Alchemy-Escape-Rooms-Inc/CoveDoor/3DFiles/3MF/LSM_Main_Mount.3mf

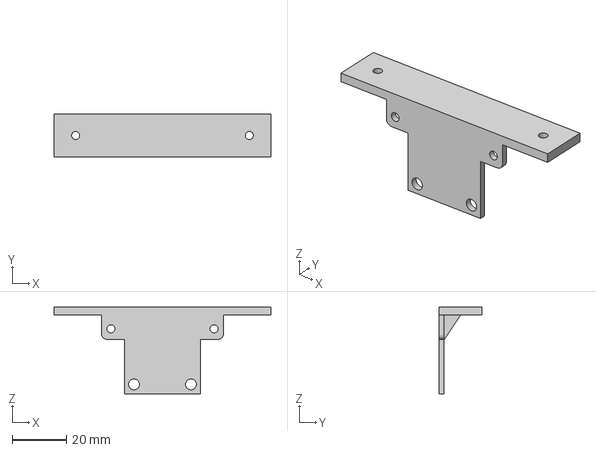
[picture p1: CAD file, 2026-04-08]
3DFiles/3MF/LSM_Main_Mount.3mf
80.0 x 16.0 x 32.0 mm
