Alchemy-Escape-Rooms-Inc/CoveDoor/3DFiles/3MF/Pinion Gear V1 (1).3mf

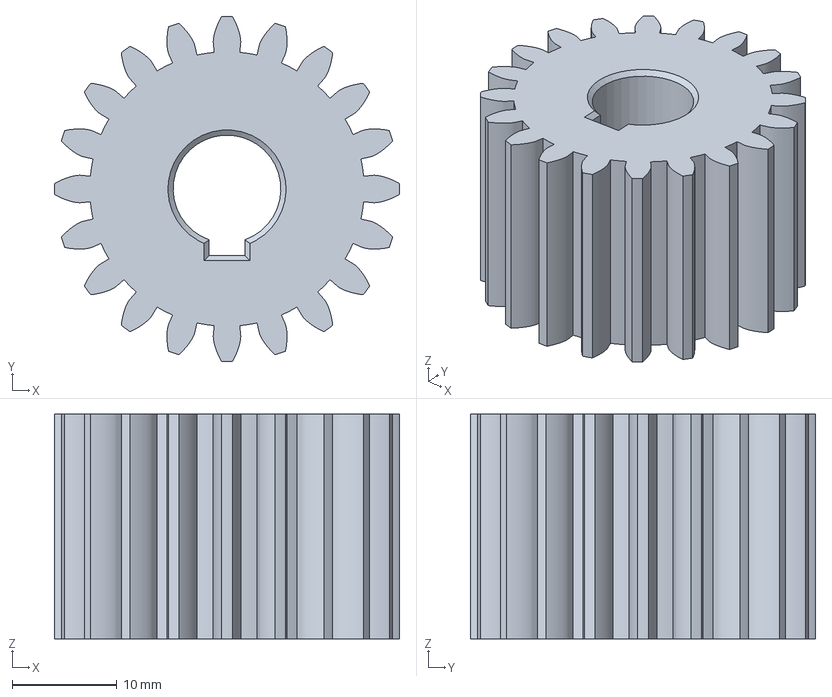
[picture p2: CAD file, 2026-06-19]
3DFiles/3MF/Pinion Gear V1 (1).3mf
33.0 x 33.0 x 21.5 mm
