Alchemy-Escape-Rooms-Inc/CoveDoor/3DFiles/3MF/CoveDoorCircuitMount.3mf

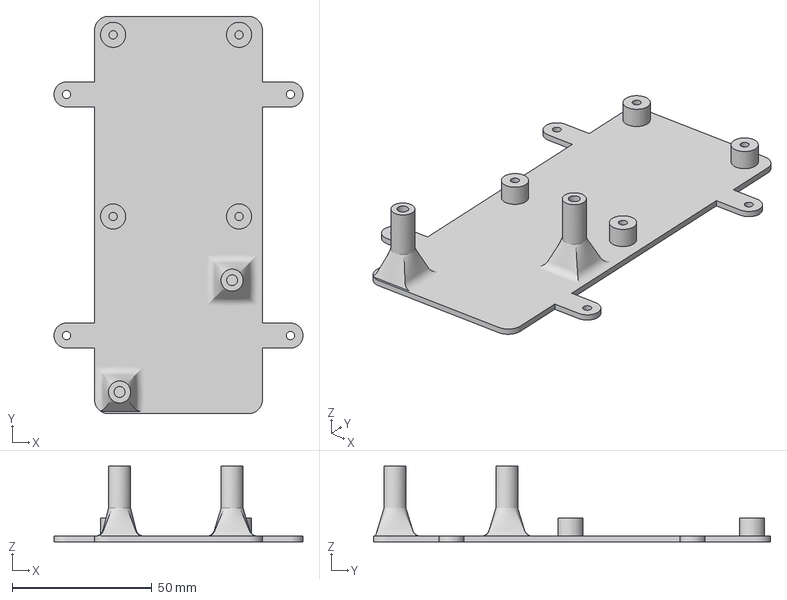
[picture p3: CAD file, 2026-04-08]
3DFiles/3MF/CoveDoorCircuitMount.3mf
89.0 x 142.0 x 27.0 mm
