Alchemy-Escape-Rooms-Inc/CoveDoor/3DFiles/3MF/LSM_Support_Mount.3mf

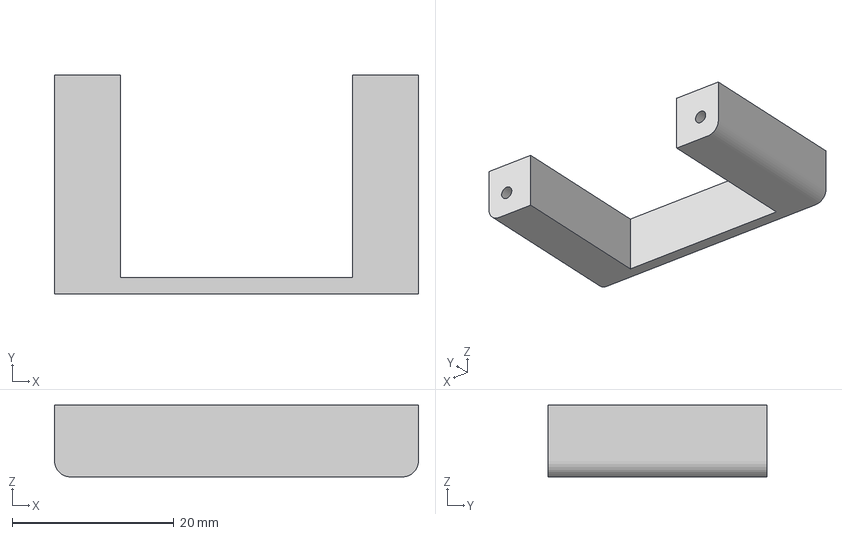
[picture p4: CAD file, 2026-04-08]
3DFiles/3MF/LSM_Support_Mount.3mf
44.9 x 27.0 x 8.88 mm
