Alchemy-Escape-Rooms-Inc/CoveDoor/Docs/Cove Door Wiring Block Diagram.pdf

# Cove Door Wiring Block Diagram

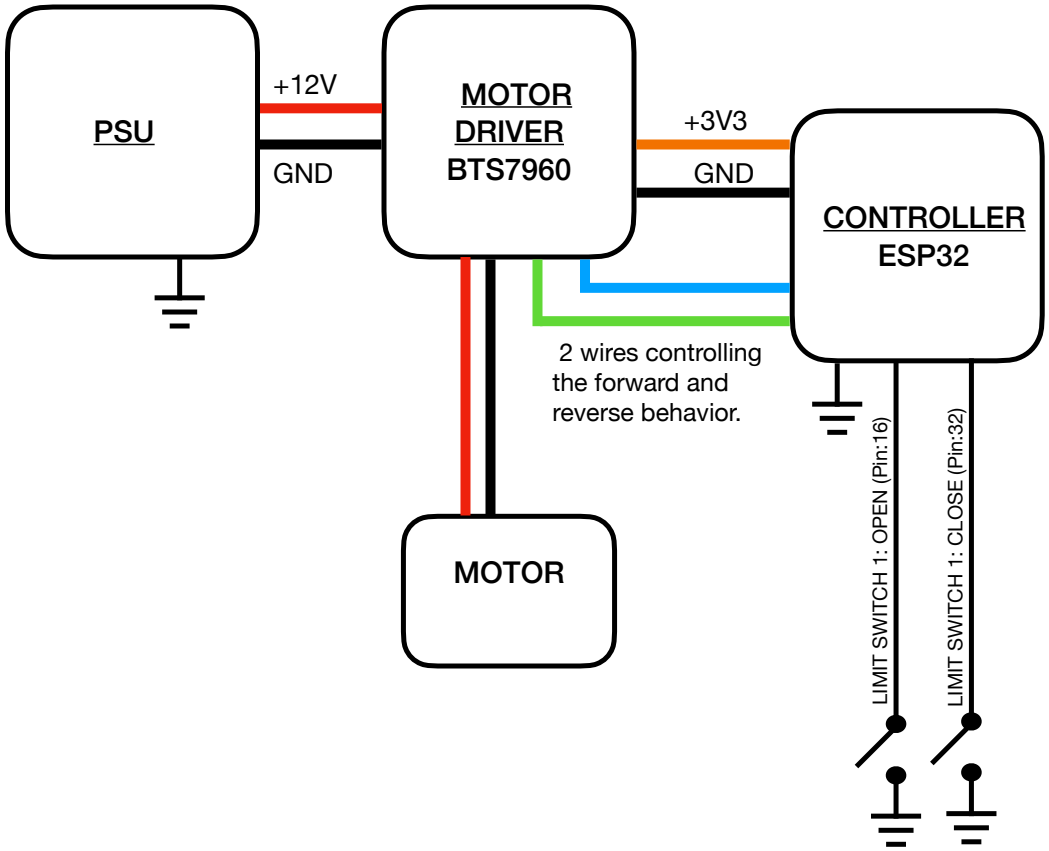
[picture p5: figure]
CONTROLLER ESP32; PSU; MOTOR; MOTOR DRIVER BTS7960; LIMIT SWITCH 1: OPEN (Pin:16); LIMIT SWITCH 1: CLOSE (Pin:32); GND; 2 wires controlling the forward and reverse behavior.
