Alchemy-Escape-Rooms-Inc/CoveDoor/Code/src/main.cpp

/*
 * ============================================
 * ALCHEMY ESCAPE ROOM - COVE SLIDING DOOR CONTROLLER
 * ESP32 + BTS7960 Dual H-Bridge Motor Driver
 * ============================================
 *
 * Uses Arduino ESP32 core 2.x ledcSetup/ledcAttachPin API.
 *
 * MQTT TOPICS:
 *   Subscribe: MermaidsTale/CoveDoor/command
 *   Publish:   MermaidsTale/CoveDoor/status
 *   Publish:   MermaidsTale/CoveDoor/log
 *   Publish:   MermaidsTale/CoveDoor/limit
 *
 * BTS7960 WIRING:
 *   RPWM -> GPIO 4  (PWM for opening)
 *   LPWM -> GPIO 19 (PWM for closing)
 *   R_EN -> 3.3V    (always enabled)
 *   L_EN -> 3.3V    (always enabled)
 * ============================================
 */

#include <Arduino.h>
#include <WiFi.h>
#include <PubSubClient.h>

#include "MANIFEST.h"

#define DEVICE_NAME       manifest::DEVICE_NAME
#define FIRMWARE_VERSION  manifest::FIRMWARE_VERSION

const char* WIFI_SSID     = manifest::WIFI_SSID;
const char* WIFI_PASSWORD = manifest::WIFI_PASSWORD;

const char* MQTT_SERVER   = manifest::MQTT_SERVER;
const int   MQTT_PORT     = manifest::MQTT_PORT;

#define RPWM_PIN        manifest::RPWM_PIN
#define LPWM_PIN        manifest::LPWM_PIN
#define LIMIT_OPEN      manifest::LIMIT_OPEN
#define LIMIT_CLOSED    manifest::LIMIT_CLOSED

#define MOTOR_SPEED     manifest::MOTOR_SPEED

#define PWM_CHANNEL_R   manifest::PWM_CHANNEL_R
#define PWM_CHANNEL_L   manifest::PWM_CHANNEL_L
#define PWM_FREQ        manifest::PWM_FREQ
#define PWM_RESOLUTION  manifest::PWM_RESOLUTION

#define LIMIT_DEBOUNCE_MS manifest::LIMIT_DEBOUNCE_MS

#define DOOR_RAMP_UP_MS     manifest::DOOR_RAMP_UP_MS
#define DOOR_TIMEOUT_MS     manifest::DOOR_TIMEOUT_MS

#define TEST_PULSE_MS       manifest::TEST_PULSE_MS
#define TEST_PAUSE_MS       manifest::TEST_PAUSE_MS

#define SERIAL_BAUD         manifest::SERIAL_BAUD
#define BOOT_SETTLE_MS      manifest::BOOT_SETTLE_MS
#define LOOP_TICK_MS        manifest::LOOP_TICK_MS
#define RESET_FLUSH_DELAY_MS manifest::RESET_FLUSH_DELAY_MS

#define MQTT_BUFFER_SIZE    manifest::MQTT_BUFFER_SIZE
#define WIFI_CONNECT_ATTEMPTS manifest::WIFI_CONNECT_ATTEMPTS
#define WIFI_ATTEMPT_DELAY_MS manifest::WIFI_ATTEMPT_DELAY_MS
#define MQTT_TOPIC_PREFIX   manifest::MQTT_TOPIC_PREFIX

String mqtt_topic_command;
String mqtt_topic_status;
String mqtt_topic_log;
String mqtt_topic_limit;

enum DoorState {
  DOOR_CLOSED,
  DOOR_OPEN,
  DOOR_OPENING,
  DOOR_CLOSING,
  DOOR_STOPPED
};

DoorState currentState = DOOR_STOPPED;
DoorState previousState = DOOR_STOPPED;

bool rawLimitOpen = false;
bool rawLimitClosed = false;
bool debouncedLimitOpen = false;
bool debouncedLimitClosed = false;
unsigned long limitOpenStableTime = 0;
unsigned long limitClosedStableTime = 0;
bool lastRawLimitOpen = false;
bool lastRawLimitClosed = false;

WiFiClient wifiClient;
PubSubClient mqtt(wifiClient);

unsigned long lastHeartbeat = 0;
unsigned long lastWifiCheck = 0;
unsigned long lastMqttReconnect = 0;
unsigned long bootTime = 0;
unsigned long motorStartTime = 0;

const unsigned long HEARTBEAT_INTERVAL = manifest::HEARTBEAT_INTERVAL;
const unsigned long WIFI_CHECK_INTERVAL = manifest::WIFI_CHECK_INTERVAL;
const unsigned long MQTT_RECONNECT_INTERVAL = manifest::MQTT_RECONNECT_INTERVAL;

char mqttLogBuffer[256];

void setup_wifi();
void setup_mqtt();
void mqtt_callback(char* topic, byte* payload, unsigned int length);
void mqtt_reconnect();
void send_heartbeat();
void send_status(const char* status);
void check_connections();
void mqttLog(const char* message);
void mqttLogf(const char* format, ...);

void startOpening();
void startClosing();
void stopMotor();
void runTestPulse(bool openDirection);
void setMotorSpeed(int openSpeed, int closeSpeed);
void checkLimitSwitches();
const char* getStateString(DoorState state);
void publishLimitEvent(const char* event);

void mqttLog(const char* message) {
  Serial.println(message);
  if (mqtt.connected()) {
    mqtt.publish(mqtt_topic_log.c_str(), message, false);
  }
}

void mqttLogf(const char* format, ...) {
  va_list args;
  va_start(args, format);
  vsnprintf(mqttLogBuffer, sizeof(mqttLogBuffer), format, args);
  va_end(args);
  mqttLog(mqttLogBuffer);
}

void publishLimitEvent(const char* event) {
  mqttLogf("[LIMIT] %s", event);
  if (mqtt.connected()) {
    mqtt.publish(mqtt_topic_limit.c_str(), event, false);
  }
}

void setup() {
  Serial.begin(SERIAL_BAUD);
  delay(BOOT_SETTLE_MS);

  Serial.println("\n============================================");
  Serial.println("   COVE SLIDING DOOR CONTROLLER - ESP32");
  Serial.println("   BTS7960 Dual H-Bridge Motor Driver");
  Serial.println("============================================");
  Serial.print("Device Name: ");
  Serial.println(DEVICE_NAME);
  Serial.print("Firmware:    ");
  Serial.println(FIRMWARE_VERSION);
  Serial.print("Compiled:    ");
  Serial.print(__DATE__);
  Serial.print(" ");
  Serial.println(__TIME__);
  Serial.println("============================================\n");

  mqtt_topic_command = String(MQTT_TOPIC_PREFIX) + DEVICE_NAME + "/command";
  mqtt_topic_status  = String(MQTT_TOPIC_PREFIX) + DEVICE_NAME + "/status";
  mqtt_topic_log     = String(MQTT_TOPIC_PREFIX) + DEVICE_NAME + "/log";
  mqtt_topic_limit   = String(MQTT_TOPIC_PREFIX) + DEVICE_NAME + "/limit";

  // BTS7960 PWM outputs — Arduino core 2.x ledcSetup/ledcAttachPin API
  ledcSetup(PWM_CHANNEL_R, PWM_FREQ, PWM_RESOLUTION);
  ledcSetup(PWM_CHANNEL_L, PWM_FREQ, PWM_RESOLUTION);
  ledcAttachPin(RPWM_PIN, PWM_CHANNEL_R);
  ledcAttachPin(LPWM_PIN, PWM_CHANNEL_L);
  ledcWrite(PWM_CHANNEL_R, 0);
  ledcWrite(PWM_CHANNEL_L, 0);
  Serial.print("[INIT] BTS7960 configured — RPWM: GPIO");
  Serial.print(RPWM_PIN);
  Serial.print(", LPWM: GPIO");
  Serial.println(LPWM_PIN);

  pinMode(LIMIT_OPEN, INPUT_PULLUP);
  pinMode(LIMIT_CLOSED, INPUT_PULLUP);
  Serial.print("[INIT] Limit switches — OPEN: GPIO");
  Serial.print(LIMIT_OPEN);
  Serial.print(", CLOSED: GPIO");
  Serial.println(LIMIT_CLOSED);

  stopMotor();

  rawLimitOpen = (digitalRead(LIMIT_OPEN) == LOW);
  rawLimitClosed = (digitalRead(LIMIT_CLOSED) == LOW);
  debouncedLimitOpen = rawLimitOpen;
  debouncedLimitClosed = rawLimitClosed;
  lastRawLimitOpen = rawLimitOpen;
  lastRawLimitClosed = rawLimitClosed;
  limitOpenStableTime = millis();
  limitClosedStableTime = millis();

  if (debouncedLimitOpen && debouncedLimitClosed) {
    Serial.println("[WARNING] BOTH limit switches triggered - check wiring!");
    currentState = DOOR_STOPPED;
  } else if (debouncedLimitClosed) {
    currentState = DOOR_CLOSED;
    Serial.println("[INIT] Door is CLOSED");
  } else if (debouncedLimitOpen) {
    currentState = DOOR_OPEN;
    Serial.println("[INIT] Door is OPEN");
  } else {
    currentState = DOOR_STOPPED;
    Serial.println("[INIT] Door position UNKNOWN");
  }
  previousState = currentState;

  setup_wifi();
  setup_mqtt();

  bootTime = millis();

  if (mqtt.connected()) {
    // ONLINE was already published by mqtt_reconnect() during setup_mqtt()
    mqttLogf("[READY] System initialized - State: %s", getStateString(currentState));
  }

  Serial.println("\n============================================");
  Serial.println("   DEVICE READY");
  Serial.println("============================================\n");
}

void loop() {
  check_connections();

  if (mqtt.connected()) {
    mqtt.loop();
  }

  send_heartbeat();
  checkLimitSwitches();

  if (currentState == DOOR_OPENING || currentState == DOOR_CLOSING) {
    unsigned long elapsed = millis() - motorStartTime;

    if (elapsed >= DOOR_TIMEOUT_MS) {
      stopMotor();
      mqttLogf("[TIMEOUT] Door %s safety timeout - no limit hit",
               currentState == DOOR_OPENING ? "open" : "close");
      currentState = DOOR_STOPPED;
      // /status "STOPPED" is published by the state-change block below
    } else {
      int speed = 0;
      if (elapsed < DOOR_RAMP_UP_MS) {
        speed = map(elapsed, 0, DOOR_RAMP_UP_MS, 0, MOTOR_SPEED);
      } else {
        speed = MOTOR_SPEED;
      }

      if (currentState == DOOR_OPENING) {
        setMotorSpeed(speed, 0);
      } else {
        setMotorSpeed(0, speed);
      }
    }
  }

  if (currentState != previousState) {
    mqttLogf("[STATE] %s -> %s", getStateString(previousState), getStateString(currentState));
    previousState = currentState;

    if (mqtt.connected()) {
      send_status(getStateString(currentState));
    }
  }

  delay(LOOP_TICK_MS);
}

void setup_wifi() {
  Serial.print("[WIFI] Connecting to ");
  Serial.print(WIFI_SSID);

  WiFi.mode(WIFI_STA);
  WiFi.begin(WIFI_SSID, WIFI_PASSWORD);

  int attempts = 0;
  while (WiFi.status() != WL_CONNECTED && attempts < WIFI_CONNECT_ATTEMPTS) {
    delay(WIFI_ATTEMPT_DELAY_MS);
    Serial.print(".");
    attempts++;
  }

  if (WiFi.status() == WL_CONNECTED) {
    Serial.println(" Connected!");
    Serial.print("[WIFI] IP: ");
    Serial.println(WiFi.localIP());
    Serial.print("[WIFI] RSSI: ");
    Serial.print(WiFi.RSSI());
    Serial.println(" dBm");
  } else {
    Serial.println(" FAILED!");
  }
}

void check_connections() {
  if (millis() - lastWifiCheck >= WIFI_CHECK_INTERVAL) {
    lastWifiCheck = millis();
    if (WiFi.status() != WL_CONNECTED) {
      Serial.println("[WIFI] Disconnected - reconnecting...");
      WiFi.disconnect();
      WiFi.begin(WIFI_SSID, WIFI_PASSWORD);
    }
  }

  if (WiFi.status() == WL_CONNECTED && !mqtt.connected()) {
    mqtt_reconnect();
  }
}

void setup_mqtt() {
  mqtt.setServer(MQTT_SERVER, MQTT_PORT);
  mqtt.setCallback(mqtt_callback);
  mqtt.setBufferSize(MQTT_BUFFER_SIZE);

  if (WiFi.status() == WL_CONNECTED) {
    mqtt_reconnect();
  }
}

void mqtt_reconnect() {
  if (millis() - lastMqttReconnect < MQTT_RECONNECT_INTERVAL) {
    return;
  }
  lastMqttReconnect = millis();

  Serial.print("[MQTT] Connecting to ");
  Serial.print(MQTT_SERVER);
  Serial.print(":");
  Serial.print(MQTT_PORT);
  Serial.print("...");

  // Unique client ID per boot: a second board flashed with this firmware
  // (or any client reusing the bare device name) would otherwise fight us
  // for the session — the broker kicks the older connection on every
  // connect, knocking the real door offline (seen live 2026-07-12).
  String clientId = String(DEVICE_NAME) + "-" + String((uint32_t)ESP.getEfuseMac(), HEX);
  if (mqtt.connect(clientId.c_str())) {
    Serial.println(" Connected!");
    mqtt.subscribe(mqtt_topic_command.c_str());
    send_status("ONLINE");
    mqttLogf("[MQTT] Connected - Current state: %s", getStateString(currentState));
  } else {
    Serial.print(" Failed (rc=");
    Serial.print(mqtt.state());
    Serial.println(")");
  }
}

void mqtt_callback(char* topic, byte* payload, unsigned int length) {
  char topicBuf[128];
  strncpy(topicBuf, topic, sizeof(topicBuf) - 1);
  topicBuf[sizeof(topicBuf) - 1] = '\0';

  char message[128];
  bool truncated = false;
  if (length >= sizeof(message)) {
    length = sizeof(message) - 1;
    truncated = true;
  }
  memcpy(message, payload, length);
  message[length] = '\0';
  if (truncated) {
    mqttLog("[MQTT] Warning: payload truncated to 127 bytes");
  }

  char* msg = message;
  while (*msg == ' ' || *msg == '\t' || *msg == '\r' || *msg == '\n') msg++;
  char* end = msg + strlen(msg) - 1;
  while (end > msg && (*end == ' ' || *end == '\t' || *end == '\r' || *end == '\n')) {
    *end = '\0';
    end--;
  }

  for (char* p = msg; *p; p++) {
    *p = toupper(*p);
  }

  if (strcmp(topicBuf, mqtt_topic_command.c_str()) != 0) {
    return;
  }

  // Our own PONG/OK/STATUS replies arrive back on /command (we subscribe
  // to it). Ignore them silently so each command doesn't bounce a junk
  // "Received"/"Unknown command" pair onto /log.
  if (strcmp(msg, "PONG") == 0 || strcmp(msg, "OK") == 0 || strlen(msg) == 0
      || strchr(msg, '|') != NULL) {
    return;
  }

  mqttLogf("[MQTT] Received on %s: %s", topicBuf, msg);

  if (strcmp(msg, "PING") == 0) {
    mqtt.publish(mqtt_topic_command.c_str(), "PONG");
    mqttLog("[CMD] PING -> PONG");
    return;
  }

  if (strcmp(msg, "STATUS") == 0) {
    unsigned long uptime = (millis() - bootTime) / 1000;
    char statusBuf[128];
    snprintf(statusBuf, sizeof(statusBuf), "%s|UP:%lus|RSSI:%d|VER:%s|LIMIT_OPEN:%s|LIMIT_CLOSED:%s",
      getStateString(currentState),
      uptime,
      WiFi.RSSI(),
      FIRMWARE_VERSION,
      debouncedLimitOpen ? "ACTIVE" : "CLEAR",
      debouncedLimitClosed ? "ACTIVE" : "CLEAR");
    mqtt.publish(mqtt_topic_command.c_str(), statusBuf);
    mqttLogf("[CMD] STATUS -> %s", statusBuf);
    return;
  }

  if (strcmp(msg, "RESET") == 0 || strcmp(msg, "REBOOT") == 0 || strcmp(msg, "RESTART") == 0) {
    mqtt.publish(mqtt_topic_command.c_str(), "OK");
    mqttLog("[CMD] RESET -> Rebooting...");
    stopMotor();
    delay(RESET_FLUSH_DELAY_MS);
    ESP.restart();
    return;
  }

  if (strcmp(msg, "PUZZLE_RESET") == 0) {
    stopMotor();
    if (debouncedLimitClosed) {
      currentState = DOOR_CLOSED;
    } else if (debouncedLimitOpen) {
      currentState = DOOR_OPEN;
    } else {
      currentState = DOOR_STOPPED;
    }
    mqtt.publish(mqtt_topic_command.c_str(), "OK");
    mqttLogf("[CMD] PUZZLE_RESET -> OK (State: %s)", getStateString(currentState));
    return;
  }

  if (strcmp(msg, "OPEN") == 0) {
    if (currentState == DOOR_OPEN) {
      mqttLog("[CMD] Door already OPEN");
      send_status("ALREADY_OPEN");
    } else if (currentState == DOOR_OPENING) {
      mqttLog("[CMD] Door already OPENING");
    } else {
      mqttLog("[CMD] OPEN command via MQTT");
      startOpening();
    }
    return;
  }

  if (strcmp(msg, "CLOSE") == 0) {
    if (currentState == DOOR_CLOSED) {
      mqttLog("[CMD] Door already CLOSED");
      send_status("ALREADY_CLOSED");
    } else if (currentState == DOOR_CLOSING) {
      mqttLog("[CMD] Door already CLOSING");
    } else {
      mqttLog("[CMD] CLOSE command via MQTT");
      startClosing();
    }
    return;
  }

  if (strcmp(msg, "STOP") == 0) {
    mqttLog("[CMD] STOP command via MQTT");
    stopMotor();
    currentState = DOOR_STOPPED;
    // /status "STOPPED" is published by the loop() state-change block
    return;
  }

  if (strcmp(msg, "TEST_MOTOR") == 0) {
    mqttLog("[TEST] Motor test starting...");
    send_status("TESTING");

    if (debouncedLimitOpen) {
      mqttLog("[TEST] Skipping open direction - already at OPEN limit");
    } else {
      mqttLog("[TEST] RPWM (open direction) ramped pulse...");
      runTestPulse(true);
      delay(TEST_PAUSE_MS);
    }

    if (debouncedLimitClosed) {
      mqttLog("[TEST] Skipping close direction - already at CLOSED limit");
    } else {
      mqttLog("[TEST] LPWM (close direction) ramped pulse...");
      runTestPulse(false);
    }

    mqttLog("[TEST] Motor test complete");

    // Sync state to physical position (a pulse may have parked us on a limit)
    if (debouncedLimitClosed) {
      currentState = DOOR_CLOSED;
    } else if (debouncedLimitOpen) {
      currentState = DOOR_OPEN;
    } else {
      currentState = DOOR_STOPPED;
    }

    if (currentState == previousState) {
      // No transition for the loop() block to announce — refresh /status
      // so WatchTower doesn't stay stuck on TESTING
      send_status(getStateString(currentState));
    }
    return;
  }

  mqttLogf("[CMD] Unknown command: %s", msg);
}

void send_status(const char* status) {
  if (!mqtt.connected()) return;
  mqtt.publish(mqtt_topic_status.c_str(), status, false);
}

void send_heartbeat() {
  if (!mqtt.connected()) return;

  if (millis() - lastHeartbeat >= HEARTBEAT_INTERVAL) {
    lastHeartbeat = millis();

    unsigned long uptime = (millis() - bootTime) / 1000;
    String heartbeat = "HEARTBEAT:";
    heartbeat += getStateString(currentState);
    heartbeat += ":UP" + String(uptime) + "s";
    heartbeat += ":RSSI" + String(WiFi.RSSI());

    mqtt.publish(mqtt_topic_status.c_str(), heartbeat.c_str(), false);
    mqttLogf("[HEARTBEAT] %s", heartbeat.c_str());
  }
}

// ============================================
// BTS7960 MOTOR CONTROL
// ============================================
void setMotorSpeed(int openSpeed, int closeSpeed) {
  // RPWM drives forward (open); LPWM drives reverse (close).
  // Only one should be non-zero at a time.
  ledcWrite(PWM_CHANNEL_R, openSpeed);
  ledcWrite(PWM_CHANNEL_L, closeSpeed);
}

void startOpening() {
  if (debouncedLimitOpen) {
    mqttLog("[INFO] Already at OPEN limit");
    currentState = DOOR_OPEN;
    stopMotor();
    return;
  }

  mqttLog("[MOTOR] Opening door (BTS7960 RPWM active)...");
  currentState = DOOR_OPENING;
  motorStartTime = millis();
  setMotorSpeed(0, 0);
  // /status "OPENING" is published by the loop() state-change block
}

void startClosing() {
  if (debouncedLimitClosed) {
    mqttLog("[INFO] Already at CLOSED limit");
    currentState = DOOR_CLOSED;
    stopMotor();
    return;
  }

  mqttLog("[MOTOR] Closing door (BTS7960 LPWM active)...");
  currentState = DOOR_CLOSING;
  motorStartTime = millis();
  setMotorSpeed(0, 0);
  // /status "CLOSING" is published by the loop() state-change block
}

void stopMotor() {
  setMotorSpeed(0, 0);
  mqttLog("[MOTOR] Motor stopped - RPWM=0, LPWM=0");
}

// Limit-aware TEST_MOTOR pulse: ramps up like a normal move and watches the
// limit switches every tick so a mid-travel test can't drive the door into
// an end stop (the raw read cuts response to ~one tick; debounce would add
// 150ms of stall against the printed pinion).
void runTestPulse(bool openDirection) {
  unsigned long start = millis();
  while (millis() - start < TEST_PULSE_MS) {
    checkLimitSwitches();
    if (openDirection && (rawLimitOpen || debouncedLimitOpen)) {
      mqttLog("[TEST] OPEN limit reached - pulse stopped early");
      break;
    }
    if (!openDirection && (rawLimitClosed || debouncedLimitClosed)) {
      mqttLog("[TEST] CLOSED limit reached - pulse stopped early");
      break;
    }
    unsigned long elapsed = millis() - start;
    int speed = (elapsed < DOOR_RAMP_UP_MS)
                  ? (int)map(elapsed, 0, DOOR_RAMP_UP_MS, 0, MOTOR_SPEED)
                  : MOTOR_SPEED;
    if (openDirection) {
      setMotorSpeed(speed, 0);
    } else {
      setMotorSpeed(0, speed);
    }
    delay(LOOP_TICK_MS);
  }
  stopMotor();
}

void checkLimitSwitches() {
  rawLimitOpen = (digitalRead(LIMIT_OPEN) == LOW);
  rawLimitClosed = (digitalRead(LIMIT_CLOSED) == LOW);

  if (rawLimitOpen != lastRawLimitOpen) {
    lastRawLimitOpen = rawLimitOpen;
    limitOpenStableTime = millis();
  } else if (rawLimitOpen != debouncedLimitOpen) {
    if (millis() - limitOpenStableTime >= LIMIT_DEBOUNCE_MS) {
      debouncedLimitOpen = rawLimitOpen;
      if (debouncedLimitOpen) {
        publishLimitEvent("LIMIT_OPEN_HIT");
        if (currentState == DOOR_OPENING) {
          mqttLog("[LIMIT] Door reached OPEN position");
          stopMotor();
          currentState = DOOR_OPEN;
        }
      } else {
        publishLimitEvent("LIMIT_OPEN_CLEAR");
      }
    }
  }

  if (rawLimitClosed != lastRawLimitClosed) {
    lastRawLimitClosed = rawLimitClosed;
    limitClosedStableTime = millis();
  } else if (rawLimitClosed != debouncedLimitClosed) {
    if (millis() - limitClosedStableTime >= LIMIT_DEBOUNCE_MS) {
      debouncedLimitClosed = rawLimitClosed;
      if (debouncedLimitClosed) {
        publishLimitEvent("LIMIT_CLOSED_HIT");
        if (currentState == DOOR_CLOSING) {
          mqttLog("[LIMIT] Door reached CLOSED position");
          stopMotor();
          currentState = DOOR_CLOSED;
        }
      } else {
        publishLimitEvent("LIMIT_CLOSED_CLEAR");
      }
    }
  }

  // Deliberate belt-and-suspenders: the transition blocks above already
  // stop the motor on a limit hit, and every code path that starts motion
  // refuses when already at the limit — so this is normally unreachable.
  // Kept anyway as a last-line safety net for a motorized door.
  if (currentState == DOOR_OPENING && debouncedLimitOpen) {
    stopMotor();
    currentState = DOOR_OPEN;
  }

  if (currentState == DOOR_CLOSING && debouncedLimitClosed) {
    stopMotor();
    currentState = DOOR_CLOSED;
  }
}

const char* getStateString(DoorState state) {
  switch (state) {
    case DOOR_CLOSED:   return "CLOSED";
    case DOOR_OPEN:     return "OPEN";
    case DOOR_OPENING:  return "OPENING";
    case DOOR_CLOSING:  return "CLOSING";
    case DOOR_STOPPED:  return "STOPPED";
    default:            return "UNKNOWN";
  }
}
