Alchemy-Escape-Rooms-Inc/CoveDoor/Code/include/MANIFEST.h

/**
 * ============================================================================
 *  ALCHEMY ESCAPE ROOMS — FIRMWARE MANIFEST
 * ============================================================================
 *
 *  THIS FILE IS THE SINGLE SOURCE OF TRUTH.
 *
 *  It serves two masters simultaneously:
 *
 *    1. THE COMPILER — Every constant the firmware needs (pins, IPs, ports,
 *       thresholds, timing) is defined here as real C++ code. The firmware
 *       #includes this file and uses these values directly.
 *
 *    2. THE GRIMOIRE PARSER — A Python script running on M3 at 6 AM reads
 *       this file as plain text and extracts values tagged with @FIELD_NAME
 *       in the comments. Those values populate the WatchTower Grimoire
 *       device registry, wiring reference, and operations manual.
 *
 *  Because both systems read from the same lines, the documentation can
 *  never drift from the firmware. Change a pin number here, and the Grimoire
 *  updates automatically. There is no second file to keep in sync.
 *
 *  RULES:
 *    1. Every field marked [REQUIRED] must be filled in before deployment.
 *    2. Update this file FIRST when changing hardware, pins, or topics.
 *    3. The 6 AM parser looks for @TAG patterns — don't rename them.
 *    4. Descriptive-only sections (operations, quirks) are pure comments.
 *       Constants sections are real code + comment tags on the same line.
 *    5. This file is the sole source of configuration values — main.cpp
 *       should reference these constants, not hardcode its own.
 *
 *  LAST UPDATED: 2026-08-10
 *  MANIFEST VERSION: 2.0
 * ============================================================================
 */

#pragma once

// ============================================================================
//  SECTION 1 — IDENTITY
// ============================================================================
//
// @MANIFEST:IDENTITY
// @PROP_NAME:        CoveDoor
// @INSTANCE_COUNT:   1
//
// @DESCRIPTION:      Secret automatic sliding door that transitions players
//                    from the Monkey Altar Room into the Cove. The door is
//                    disguised as part of the room wall — players do not know
//                    it exists until it opens. A BTS7960 dual H-bridge motor
//                    driver controls a DC motor that slides the door along a
//                    track. Two magnetic reed switches define the open and
//                    closed positions.
//                    The door responds to OPEN, CLOSE, and STOP commands via
//                    MQTT, with smooth ramped motor acceleration for
//                    theatrical effect (stops are instant — at a limit,
//                    on timeout, or on STOP; there is no ramp-down).
//
// @ROOM:             Monkey Altar Room (transitions to Cove)
// @BOARD:            ESP32-DevKitC (regular ESP32)
// @FRAMEWORK:        Arduino (PlatformIO)
// @REPO:             https://github.com/Alchemy-Escape-Rooms-Inc/CoveDoor
// @BUILD_STATUS:     INSTALLED
// @CODE_HEALTH:      GOOD
// @WATCHTOWER:       COMPLIANT
// @END:IDENTITY

namespace manifest {

// ── Device Identity ─────────────────────────────────────────────────────────
inline constexpr const char* DEVICE_NAME      = "CoveDoor";       // @DEVICE_NAME  (MQTT client ID + topic base)
inline constexpr const char* FIRMWARE_VERSION  = "1.3.4";         // @FIRMWARE_VERSION  (motor PWM swapped: RPWM=4, LPWM=19)


// ============================================================================
//  SECTION 2 — NETWORK CONFIGURATION
// ============================================================================
// @MANIFEST:NETWORK

// ── WiFi ────────────────────────────────────────────────────────────────────
inline constexpr const char* WIFI_SSID     = "AlchemyGuest";      // @WIFI_SSID
inline constexpr const char* WIFI_PASSWORD = "VoodooVacation5601"; // @WIFI_PASS

// ── WiFi Connect Retry (boot) ───────────────────────────────────────────────
inline constexpr int WIFI_CONNECT_ATTEMPTS = 40;                  // @WIFI:CONNECT_ATTEMPTS | Boot WiFi retries (x delay = 20s max wait)
inline constexpr int WIFI_ATTEMPT_DELAY_MS = 500;                 // @WIFI:ATTEMPT_DELAY    | Delay between boot WiFi retries

// ── MQTT Broker ─────────────────────────────────────────────────────────────
inline constexpr const char* MQTT_SERVER   = "10.1.10.115";       // @BROKER_IP
inline constexpr int         MQTT_PORT     = 1883;                // @BROKER_PORT
inline constexpr const char* MQTT_TOPIC_PREFIX = "MermaidsTale/"; // @TOPIC_PREFIX | Base of every topic: prefix + DEVICE_NAME + suffix
inline constexpr int         MQTT_BUFFER_SIZE  = 512;             // @MQTT:BUFFER  | PubSubClient packet buffer bytes
// MQTT Client ID: "CoveDoor-<efuse MAC suffix>" (unique per board; prevents
// a duplicate-ID kick war if a second board runs this firmware)

// ── Heartbeat ───────────────────────────────────────────────────────────────
inline constexpr unsigned long HEARTBEAT_INTERVAL = 300000;       // @HEARTBEAT_MS  (5 minutes, per WatchTower spec)

//  ── TOPIC MAP ──────────────────────────────────────────────────────────────
//  Topics are built dynamically from DEVICE_NAME at runtime:
//    "MermaidsTale/" + DEVICE_NAME + "/{suffix}"
//
//  SUBSCRIPTIONS:
//  @SUBSCRIBE:  MermaidsTale/CoveDoor/command      | All commands (standard + door control)
//
//  PUBLICATIONS:
//  @PUBLISH:  MermaidsTale/CoveDoor/command         | PONG, STATUS, OK responses  | retain:no
//  @PUBLISH:  MermaidsTale/CoveDoor/status          | State changes + heartbeat   | retain:no
//  @PUBLISH:  MermaidsTale/CoveDoor/log             | Mirrored serial output      | retain:no
//  @PUBLISH:  MermaidsTale/CoveDoor/limit           | Limit switch events         | retain:no
//
//  NOTE: PONG and STATUS responses publish on /command (not /status).
//        This differs from JungleDoor which publishes PONG on /status.
//
//  SUPPORTED COMMANDS (via /command topic):
//  @COMMAND:  PING          | Responds PONG on /command topic         | Health check
//  @COMMAND:  STATUS        | Sends state report on /command topic    | Full diagnostic
//  @COMMAND:  RESET         | Stops motor, reboots ESP32              | Also accepts REBOOT, RESTART
//  @COMMAND:  PUZZLE_RESET  | Stops motor, re-reads limits, resets state | No reboot
//  @COMMAND:  OPEN          | Opens the door (ramp up → full speed → instant stop at limit)
//  @COMMAND:  CLOSE         | Closes the door (ramp up → full speed → instant stop at limit)
//  @COMMAND:  STOP          | Emergency stop — kills motor immediately
//  @COMMAND:  TEST_MOTOR    | Limit-aware ramped pulse in each direction | Publishes TESTING; skips a direction already at its limit, stops early on limit hit
//
//  LIMIT SWITCH EVENTS (published on /limit topic):
//  @LIMIT_EVENT:  LIMIT_OPEN_HIT      | Door reached fully open position
//  @LIMIT_EVENT:  LIMIT_CLOSED_HIT    | Door reached fully closed position
//  @LIMIT_EVENT:  LIMIT_OPEN_CLEAR    | Door moved away from open limit
//  @LIMIT_EVENT:  LIMIT_CLOSED_CLEAR  | Door moved away from closed limit
//
//  STATUS MESSAGES (published on /status topic):
//  @STATUS_MSG:  ONLINE          | Sent on boot and MQTT reconnect
//  @STATUS_MSG:  OPENING         | Door motor started, opening direction
//  @STATUS_MSG:  CLOSING         | Door motor started, closing direction
//  @STATUS_MSG:  OPEN            | Door reached open position (limit or timeout)
//  @STATUS_MSG:  CLOSED          | Door reached closed position (limit or timeout)
//  @STATUS_MSG:  STOPPED         | Motor stopped via STOP command or safety timeout
//  @STATUS_MSG:  TESTING         | TEST_MOTOR sequence running
//  @STATUS_MSG:  ALREADY_OPEN    | OPEN command received but door already open
//  @STATUS_MSG:  ALREADY_CLOSED  | CLOSE command received but door already closed
//  @STATUS_MSG:  HEARTBEAT:...   | Periodic heartbeat with state, uptime, RSSI
//
//  NOTE (v1.3.0): each state transition publishes exactly ONE /status message
//  (the loop state-change block is the single publisher; the pre-1.3.0
//  double-publish of STOPPED/OPENING/CLOSING and the double ONLINE at boot
//  are gone).
//
// @END:NETWORK


// ============================================================================
//  SECTION 3 — PIN CONFIGURATION
// ============================================================================
// @MANIFEST:PINS

// ── Motor Driver (BTS7960 Dual H-Bridge) ────────────────────────────────────
// 2026-08-10: moved motor PWM off the strapping pins (2/5) onto 19/4, then
// swapped the pair same day (v1.3.4) so OPEN drives the correct direction —
// matches the 08-08 bench finding that OPEN ran backwards.
inline constexpr int RPWM_PIN = 4;                                // @PIN:RPWM   | BTS7960 RPWM — forward/open direction PWM
inline constexpr int LPWM_PIN = 19;                               // @PIN:LPWM   | BTS7960 LPWM — reverse/close direction PWM

// ── Limit Switches ──────────────────────────────────────────────────────────
// 2026-08-08: moved 16/17 → 33/32 for the replacement door board (user
// request). CLOSED returns to its pre-July GPIO 32. The GPIO33_AVOIDED quirk
// below was a defect on ONE old board's internal pull-up — verify 33 reads
// HIGH-when-open on this board via STATUS before trusting the open limit.
inline constexpr int LIMIT_OPEN   = 33;                           // @PIN:LIMIT_OPEN   | Magnetic reed switch, INPUT_PULLUP, active LOW
inline constexpr int LIMIT_CLOSED = 32;                           // @PIN:LIMIT_CLOSED | Magnetic reed switch, INPUT_PULLUP, active LOW

// @END:PINS


// ============================================================================
//  SECTION 4 — MOTOR CONFIGURATION
// ============================================================================
// @MANIFEST:MOTOR

inline constexpr int MOTOR_SPEED = 220;                           // @MOTOR:SPEED | PWM duty 0-255 (220 ≈ 86%)

// ── PWM Configuration ───────────────────────────────────────────────────────
inline constexpr int PWM_CHANNEL_R = 0;                           // @PWM:CHANNEL_R  | LEDC channel for RPWM (open)
inline constexpr int PWM_CHANNEL_L = 1;                           // @PWM:CHANNEL_L  | LEDC channel for LPWM (close)
inline constexpr int PWM_FREQ      = 5000;                        // @PWM:FREQ       | 5kHz PWM frequency
inline constexpr int PWM_RESOLUTION = 8;                          // @PWM:RESOLUTION | 8-bit (0-255)

// ── Door Movement Timing ────────────────────────────────────────────────────
inline constexpr int DOOR_RAMP_UP_MS    = 500;                    // @DOOR:RAMP_UP    | 0.5s acceleration to full speed
inline constexpr int DOOR_TIMEOUT_MS    = 12000;                  // @DOOR:TIMEOUT    | 12s safety timeout if limit switch not hit

// ── TEST_MOTOR Pulses ───────────────────────────────────────────────────────
inline constexpr int TEST_PULSE_MS      = 2000;                   // @TEST:PULSE_MS | Max duration of each ramped test pulse (limit-aware, stops early)
inline constexpr int TEST_PAUSE_MS      = 500;                    // @TEST:PAUSE_MS | Pause between the open and close test pulses

// @END:MOTOR


// ============================================================================
//  SECTION 5 — SENSOR THRESHOLDS
// ============================================================================
// @MANIFEST:THRESHOLDS

// ── Debounce ────────────────────────────────────────────────────────────────
inline constexpr int LIMIT_DEBOUNCE_MS = 150;                     // @DEBOUNCE:LIMIT  | 150ms debounce for both limit switches

// @END:THRESHOLDS


// ============================================================================
//  SECTION 6 — TIMING CONSTANTS
// ============================================================================
// @MANIFEST:TIMING

inline constexpr unsigned long WIFI_CHECK_INTERVAL     = 30000;   // @TIMING:WIFI_CHECK     | Check WiFi connection every 30s
inline constexpr unsigned long MQTT_RECONNECT_INTERVAL = 5000;    // @TIMING:MQTT_RECONNECT | Retry MQTT connection every 5s

inline constexpr long SERIAL_BAUD           = 115200;             // @TIMING:SERIAL_BAUD    | Serial monitor baud (matches platformio.ini monitor_speed)
inline constexpr int  BOOT_SETTLE_MS        = 1000;               // @TIMING:BOOT_SETTLE    | Post-Serial.begin settle delay at boot
inline constexpr int  LOOP_TICK_MS          = 10;                 // @TIMING:LOOP_TICK      | Main loop tick / test-pulse limit poll interval
inline constexpr int  RESET_FLUSH_DELAY_MS  = 100;                // @TIMING:RESET_FLUSH    | Delay to flush MQTT "OK" before ESP.restart()

// @END:TIMING

} // namespace manifest


// ============================================================================
//  SECTION 7 — COMPONENTS
// ============================================================================
//
// @MANIFEST:COMPONENTS
//
// @COMPONENT:  BTS7960 Dual H-Bridge Motor Driver
//   @PURPOSE:  Controls the DC motor that slides the door along its track
//   @DETAIL:   Dual PWM interface. RPWM drives the forward/open direction,
//              LPWM drives the reverse/close direction. Only one PWM output
//              is active at a time. R_EN and L_EN are tied to 3.3V so both
//              half-bridges are always enabled. Motor runs at 86% duty
//              (220/255) with smooth ramp-up for theatrical door movement.
//
// @COMPONENT:  DC Sliding Door Motor
//   @PURPOSE:  Physically moves the door panel along a track
//   @DETAIL:   Driven by BTS7960. Opens via RPWM, closes via LPWM.
//              Total travel time a few seconds with ramping; 12s safety timeout.
//
// @COMPONENT:  Magnetic Reed Switch (Open Position)
//   @PURPOSE:  Detects when door has fully opened
//   @DETAIL:   Pin 33, INPUT_PULLUP, active LOW. Magnet mounted on door panel.
//
// @COMPONENT:  Magnetic Reed Switch (Closed Position)
//   @PURPOSE:  Detects when door has fully closed
//   @DETAIL:   Pin 32, INPUT_PULLUP, active LOW. Magnet mounted on door panel.
//
// @END:COMPONENTS


// ============================================================================
//  SECTION 8 — OPERATIONS
// ============================================================================
//
// @MANIFEST:OPERATIONS
//
//  ── PHYSICAL LOCATION ──────────────────────────────────────────────────────
//
// @LOCATION:  Hidden above the door frame. The ESP32 and BTS7960 motor
//             driver are mounted in the space directly above the CoveDoor.
//             Access from above.
//
//  ── RESET PROCEDURES ───────────────────────────────────────────────────────
//
// @RESET:SOFTWARE
//   Send "RESET" (or "REBOOT" or "RESTART") to MermaidsTale/CoveDoor/command
//   Device responds "OK" on /command, stops motor, then reboots
//   After reboot: reconnects WiFi, reconnects MQTT, reads limit switches
//   to determine initial door position, publishes ONLINE
//   Expected recovery time: 10-15 seconds
//
// @RESET:PUZZLE
//   Send "PUZZLE_RESET" to MermaidsTale/CoveDoor/command
//   Stops motor, re-reads limit switches, sets state to match physical
//   position (CLOSED if closed limit active, OPEN if open limit active,
//   STOPPED if neither). No reboot, no WiFi/MQTT reconnect.
//   Responds "OK" on /command topic.
//   Use between game sessions to sync state with physical door position.
//
// @RESET:HARDWARE
//   The ESP32 and BTS7960 are hidden above the door frame. Access from above,
//   disconnect and reconnect power to the ESP32. After power-on, monitor
//   MermaidsTale/CoveDoor/status for ONLINE message. The door will read its
//   limit switches on boot to determine its current position.
//
//  ── DOOR OPERATION ─────────────────────────────────────────────────────────
//
// @OPERATION:OPEN
//   Send "OPEN" to MermaidsTale/CoveDoor/command
//   Ramps RPWM up over 0.5s to duty 220, LPWM stays at 0.
//   Publishes "OPENING" immediately, then "OPEN" when complete.
//   Stops instantly (no ramp-down) when the open limit switch triggers.
//   Falls back to 12-second timer if limit switch doesn't fire.
//
// @OPERATION:CLOSE
//   Send "CLOSE" to MermaidsTale/CoveDoor/command
//   Ramps LPWM up over 0.5s to duty 220, RPWM stays at 0.
//   Publishes "CLOSING" immediately, then "CLOSED" when complete.
//   Stops instantly (no ramp-down) when the closed limit switch triggers.
//   Falls back to 12-second timer if limit switch doesn't fire.
//
// @OPERATION:TEST_MOTOR
//   Send "TEST_MOTOR" to MermaidsTale/CoveDoor/command
//   Publishes "TESTING", then runs a ramped pulse (max 2s) in each
//   direction. Limit-aware: skips a direction whose limit is already
//   active, and monitors both switches every 10ms DURING each pulse,
//   stopping early on a hit — safe to run with the door mid-travel.
//   Ends by syncing state to the physical position (CLOSED/OPEN/STOPPED)
//   and publishing it on /status.
//
// @OPERATION:EMERGENCY_STOP
//   Send "STOP" to MermaidsTale/CoveDoor/command
//   Both RPWM and LPWM are immediately set to 0 — no ramp-down.
//   Publishes "STOPPED" on /status.
//   Door remains in whatever position it stopped at.
//
//  ── TEST PROCEDURE ─────────────────────────────────────────────────────────
//
// @TEST:STEP1  Send PING to /command → expect PONG on /command (confirms MQTT)
// @TEST:STEP2  Send STATUS to /command → expect state, uptime, RSSI, version, limit states on /command
// @TEST:STEP3  Send OPEN to /command → door should slide open, expect OPENING then OPEN on /status
// @TEST:STEP4  Verify LIMIT_OPEN_HIT appears on /limit topic when door reaches open position
// @TEST:STEP5  Send CLOSE to /command → door should slide closed, expect CLOSING then CLOSED on /status
// @TEST:STEP6  Verify LIMIT_CLOSED_HIT appears on /limit topic when door reaches closed position
// @TEST:STEP7  Send STOP during movement → motor should stop immediately
// @TEST:STEP8  Send PUZZLE_RESET → expect OK on /command, state syncs to physical position
// @TEST:STEP9  Send TEST_MOTOR → expect TESTING on /status, a short ramped pulse each direction (skipped/cut at limits), then the synced state on /status
//
//  ── KNOWN QUIRKS ───────────────────────────────────────────────────────────
//
// @QUIRK:BOARD_HISTORY
//   This prop has bounced between boards and drivers. Current installed
//   hardware: regular ESP32-DevKitC + BTS7960. A brief detour migrated the
//   repo to XY160D and an ESP32-S3; both were reverted. Final pin assignment:
//   RPWM=GPIO 4, LPWM=GPIO 19, LIMIT_OPEN=GPIO 33, LIMIT_CLOSED=GPIO 32
//   (limits were 16/17 from July until the 08-08 replacement board;
//   motor PWM was 2/5 until 08-10: first 19/4, then swapped to 4/19
//   for correct OPEN direction).
//
// @QUIRK:NO_WATCHDOG
//   This firmware does not implement a hardware watchdog timer. If the main
//   loop hangs (e.g., WiFi blocking, MQTT stall), the device will not
//   auto-recover. A manual RESET command or hardware power cycle is required.
//   Consider adding esp_task_wdt for future versions.
//
// @QUIRK:TIMEOUT_BACKUP
//   The 12-second movement timer serves as a backup timeout. The limit
//   switches are the primary stop mechanism and are working reliably. If a
//   limit switch fails to trigger within 12 seconds, the motor stops anyway
//   and the firmware logs "[TIMEOUT] Door open/close safety timeout - no
//   limit hit" on the /log topic. If you see timeout messages, check the
//   limit switches.
//
// @QUIRK:PONG_ON_COMMAND
//   PONG and STATUS responses are published on the /command topic, not
//   /status. This is different from JungleDoor (which publishes PONG on
//   /status). WatchTower System Checker should listen on /command for
//   health check responses from this device. Since v1.2.0 the firmware
//   silently ignores its own replies arriving back on /command (PONG, OK,
//   empty, or any '|' diagnostics string) so commands no longer bounce
//   junk "Received"/"Unknown command" lines onto /log.
//
// @QUIRK:LEDC_API_VERSION
//   This firmware targets regular ESP32 on Arduino core 2.x and uses the
//   older ledcSetup(channel, freq, res) + ledcAttachPin(pin, channel) +
//   ledcWrite(channel, duty) API. platformio.ini pins the platform to
//   espressif32@6.9.0 for this reason — do not bump without migrating
//   the PWM calls to the core 3.x ledcAttach()/ledcWrite(pin,...) API.
//
//  ── TROUBLESHOOTING LOG (2026-02-14) ───────────────────────────────────────
//
// @QUIRK:STRAPPING_PINS
//   On the regular ESP32, GPIO 0, 2, 5, 12, and 15 are strapping pins.
//   Historical: RPWM/LPWM sat on GPIO 2/5 (both strapping pins) through
//   v1.3.2 and booted reliably anyway. As of v1.3.3/1.3.4 the motor PWM is
//   on GPIO 4/19 — neither is a strapping pin, so the BTS7960 can no longer
//   interfere with boot mode.
//
// @QUIRK:GPIO33_AVOIDED
//   An earlier iteration put LIMIT_CLOSED on GPIO 33 and hit a defective
//   internal pull-up on that specific board (stuck at 0.55V) — a board
//   defect, not a chip-family issue. As of v1.3.2 the limits are BACK on
//   33/32 (LIMIT_OPEN=33, LIMIT_CLOSED=32) on the 08-08 replacement board
//   (MAC ec:e3:34:19:83:a8). Verify via STATUS that both limits read CLEAR
//   with no magnet present; a stuck-ACTIVE LIMIT_OPEN means this board's
//   GPIO 33 pull-up is bad too — move it and reflash.
//
// @END:OPERATIONS


// ============================================================================
//  SECTION 9 — DEPENDENCIES
// ============================================================================
//
// @MANIFEST:DEPENDENCIES
//
// @LIB:  WiFi              | ESP32 WiFi driver          | Built-in
// @LIB:  PubSubClient      | MQTT client                | v2.8+
//
// @END:DEPENDENCIES


// ============================================================================
//  SECTION 10 — WIRING SUMMARY
// ============================================================================
//
// @MANIFEST:WIRING
//
//   ESP32 Pin 4  (RPWM) ──────── BTS7960 RPWM (forward / open PWM)
//   ESP32 Pin 19 (LPWM) ──────── BTS7960 LPWM (reverse / close PWM)
//   3.3V             ─────────── BTS7960 R_EN (always enabled)
//   3.3V             ─────────── BTS7960 L_EN (always enabled)
//
//   ESP32 Pin 33 ─────────────── Magnetic Reed Switch (OPEN position)
//                                 Closes to GND when magnet is nearby
//                                 INPUT_PULLUP, active LOW
//
//   ESP32 Pin 32 ─────────────── Magnetic Reed Switch (CLOSED position)
//                                 Closes to GND when magnet is nearby
//                                 INPUT_PULLUP, active LOW
//
//   BTS7960 VCC  ─────────────── Motor power supply (12V/24V)
//   BTS7960 GND  ─────────────── Common ground with ESP32
//   BTS7960 M+/M- ────────────── DC sliding door motor
//
//   ESP32 Power ──────────────── USB, hidden above the door frame
//
//   Physical Location: Hidden above the door frame, accessible from above
//
// @END:WIRING
