Alchemy-Escape-Rooms-Inc/CoveDoor/(commit log)

2026-02-11 Initial commit: Cove Sliding Door Controller
    ESP32-S3 + BTS7960 dual H-bridge motor driver
    Watchtower Protocol compliant
    MQTT integration for remote control
2026-02-12 Remove unused status LED pins (GPIO 21, 22, 23)
    These GPIOs were causing errors on ESP32-S3 modules where they
    conflict with SPI flash/PSRAM. The status LEDs were not physically
    connected, so all related code has been removed.
    [main.cpp]
2026-02-12 Change limit switch pins to GPIO 38 and 39
2026-02-14 Add MANIFEST.h, bridge main.cpp, and update board to ESP32
    Adds self-documenting firmware manifest with @TAG markers for Grimoire
    parser. main.cpp bridges all config values from manifest:: namespace.
    platformio.ini updated from ESP32-S3 to regular ESP32 — limit switch
    pins moved from GPIO 38/39 to 32/33 for INPUT_PULLUP compatibility.
    Zero changes to function calls or logic.
2026-02-14 Update limit switches: GPIO 33→16/32, mechanical→magnetic reed
    GPIO 33 internal pull-up defective on installed board (stuck at 0.55V).
    Moved LIMIT_OPEN to GPIO 16, LIMIT_CLOSED stays on GPIO 32.
    Switched from mechanical limit switches to magnetic reed switches.
    No code changes needed — main.cpp reads pins from manifest automatically.
    [MANIFEST.h]
2026-02-14 Add troubleshooting log: GPIO 5 boot crash and GPIO 33 defective pull-up
    Documents two hardware issues discovered during bench testing:
    - GPIO 5 strapping pin causes boot-loop with invalid flash headers when
    screw terminal makes contact during power-on
    - GPIO 33 internal pull-up defective on installed board (0.55V not 3.3V)
    Both include symptoms, root cause, fix, and notes for future reference.
    [MANIFEST.h]
2026-02-14 Replace timed ramp profile with 8s safety timeout
    Remove the old 4s ramp-up/full-speed/ramp-down timer that faked
    successful state transitions on timeout. Motor now ramps up then
    runs at full speed until limit switches stop it, with an 8s safety
    timeout that transitions to DOOR_STOPPED on failure.
    [MANIFEST.h, main.cpp]
2026-02-14 Clear limit hit status on every door state change
    Publish CLEAR to the /limit MQTT topic whenever currentState
    changes, so stale LIMIT_OPEN_HIT or LIMIT_CLOSED_HIT messages
    don't persist after the door begins a new movement.
2026-02-14 Add TEST_MOTOR command for wiring verification
    Sends MOTOR_SPEED PWM to RPWM for 2s, then LPWM for 2s, to
    verify BTS7960 wiring and motor output without needing limit
    switches. Publish via MQTT: TEST_MOTOR on /command topic.
2026-02-15 Move RPWM pin from GPIO 4 to GPIO 2
2026-02-15 Replace BTS7960 motor driver with XY160D
    Swap from dual-PWM (RPWM/LPWM) to DIR+PWM (IN1/IN2/ENA) interface.
    IN1=GPIO2, IN2=GPIO5, ENA=GPIO4. Single LEDC channel for speed
    control, digital pins for direction. All MQTT commands, limit
    switches, ramping, and Watchtower protocol unchanged.
    [MANIFEST.h, main.cpp]
2026-04-04 Organized files, and added a few CAD files for different mounts.
    [CoveDoorCircuitMount.3mf, LSM_Main_Mount.3mf, LSM_Support_Mount.3mf]
2026-04-08 Added basic wiring diagram of the system.
2026-04-14 Bump motor speed, extend safety timeout, and clean up protocol drift
    - MOTOR_SPEED 150 -> 180 (~71% duty) for faster door travel
    - DOOR_TIMEOUT_MS 8000 -> 12000 (12s safety backup)
    - HEARTBEAT_INTERVAL 30s -> 300s to match WatchTower spec
    - Remove unused EMERGENCY_STOP enum value
    - Remove undocumented "CLEAR" publish on /limit topic
    - Log a warning when MQTT payload is truncated
    - Fix stale BTS7960 references in platformio.ini and MANIFEST.h
    [MANIFEST.h, main.cpp]
2026-04-14 Migrate firmware to ESP32-S3 + BTS7960 to match installed hardware
    The repo had been migrated to regular ESP32 + XY160D in 69b4c09, but
    the physically installed board is an ESP32-S3-DevKitC-1 (N8R8) with a
    BTS7960 driver. Field is the source of truth; reverting the firmware
    to BTS7960 and porting to ESP32-S3 on Arduino core 3.x.
    - main.cpp: restore BTS7960 RPWM/LPWM motor control, use ledcAttach
    API (core 3.x, ledcWrite takes pin not channel)
    - MANIFEST.h: pin map is RPWM=2, LPWM=5, LIMIT_OPEN=16, LIMIT_CLOSED=17
    (GPIO 32 doesn't exist on S3), board updated, wiring/components/quirks
    rewritten for S3+BTS7960, PWM channel constants removed
    - platformio.ini: board=esp32-s3-devkitc-1, unp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
    [MANIFEST.h, main.cpp]
2026-04-14 Revert to regular ESP32 + BTS7960, match installed hardware
    The S3 migration was rolled back in the field. Current installed
    hardware is the regular ESP32-DevKitC with BTS7960, reed switches on
    GPIO 16 and 32. Firmware reverts the LEDC API to the 2.x
    ledcSetup/ledcAttachPin calls and pins PlatformIO platform to
    espressif32@6.9.0 so the old API keeps compiling.
    Pin map: RPWM=2, LPWM=5, LIMIT_OPEN=16, LIMIT_CLOSED=32.
    Audit fixes preserved: MOTOR_SPEED=180, DOOR_TIMEOUT_MS=12000,
    HEARTBEAT_INTERVAL=300000.
    Compile + flash verified on the installed ESP32-D0WD-V3 (COM5).
    [MANIFEST.h, main.cpp]
2026-04-14 Move LIMIT_CLOSED from GPIO 32 to GPIO 17
    GPIO 17 is a safe non-strapping input with a working internal pull-up
    on the regular ESP32. Requires physically moving the closed reed
    switch wire on the installed board.
2026-05-29 Speed up CoveDoor: MOTOR_SPEED 180 -> 220 (~86% duty)
    Bump motor PWM duty for a faster door per request. MANIFEST.h is the
    single source of truth; main.cpp already reads manifest::MOTOR_SPEED so
    no code change is needed. Updated the COMPONENTS doc comment to match
    and logged the session.
2026-06-19 Add Pinion Gear V1 3MF print file
    [Pinion Gear V1 (1).3mf]
2026-07-12 Unique MQTT client ID per board (v1.1.0)
    mqtt.connect() used the bare DEVICE_NAME as client ID. When a second
    board flashed with this firmware is powered anywhere on the network
    (observed 2026-07-12: a spare board online since 07-09), the broker
    kicks whichever connection is older on every connect -- the two boards
    knock each other offline all day and the door goes deaf to commands.
    Suffix the client ID with the chip's eFuse MAC so every physical board
    gets a stable, unique identity. Bump FIRMWARE_VERSION to 1.1.0.
    [MANIFEST.h, main.cpp]
2026-07-25 v1.2.0: self-ignore guard on /command + limit-aware motor test
    Ignore our own PONG/OK/diagnostic replies arriving back on /command so
    commands no longer bounce junk Received/Unknown-command lines onto
    /log. Motor TEST now skips a direction when already at that limit.
    Drop unused systemReady flag. Log flashing quirk (hold BOOT +
    --before no_reset).
    [MANIFEST.h, main.cpp]
2026-07-29 v1.3.0: limit-aware TEST_MOTOR, single status per transition, manifest truth-up
    - TEST_MOTOR: ramped pulses that poll limit switches every 10ms and stop
    early on a hit (was: blind 2s full-duty delay that could stall the motor
    against the end stop mid-travel); ends by syncing state to physical position
    - Dedup /status: loop state-change block is the single publisher (removes
    doubled STOPPED/OPENING/CLOSING and double ONLINE at boot)
    - Move all magic numbers into MANIFEST.h per its own Rule 5
    - MANIFEST: fix @REPO URL, stale duty 180->220, false ramp-down claims,
    timeout wording; document TEST_MOTOR + TESTING; drop unused <cstdint>
    - Add .gitignore (.pio/), remove empty zigbee-devices/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
    [MANIFEST.h, main.cpp]
2026-07-29 Deploy log 2026-07-29: v1.3.0 flashed+verified to bench board; retained OPEN wiped; COM26 Sonoff dongle trap
2026-08-08 v1.3.2: limit switches 16/17 -> 33/32 for replacement door board
    08-08: the door ESP32's USB port was ripped off (board is USB-powered,
    so dead). Replacement D0WD-V3 (MAC ec:e3:34:19:83:a8) wired with limits
    on 33/32 per user. GPIO33_AVOIDED quirk was a single bad board's pull-up,
    not a chip issue - quirk text updated with a STATUS-based recheck.
    Motor-only ESP32 line continues on this branch; master moved to the
    combined S3 firmware (v2.0.0-S3).
    [MANIFEST.h]
2026-08-10 v1.3.3: motor PWM pins 2/5 -> 19/4 (RPWM=19, LPWM=4)
    Moves the BTS7960 PWM lines off the regular ESP32's strapping pins
    (GPIO 2/5) onto plain GPIOs per rewiring. Limits stay 33/32.
2026-08-10 v1.3.4: swap motor PWM pins (RPWM=4, LPWM=19) for correct OPEN/CLOSE direction
    Reverses the v1.3.3 assignment per live door behavior - matches the
    08-08 bench finding that OPEN drove the wrong way.
    [MANIFEST.h, main.cpp]
